robotond/wd_relay3/README.md

# wd_relay3
Highlights:
MCU platform: STM32G070CBT6
On board switching power supply with XL1509-ADJ
RS-485 interface
2 pcs of safety DPDT relays with hardware watchdog timers (SN74AHC123)
1 pc DPDT relay.
MAX 24V DC only
HW: KiCAD project with schematics, PCB, gerbers
SW: STM32CUBEIDE Version: 1.12.1 Build: 16088_20230420_1057 (UTC)
