robotond/wd_relay3/HARDWARE/wd_relay3/wd_relay3.kicad_pcb

## KiCad design HARDWARE/wd_relay3/wd_relay3.kicad_pcb (2023-06-29)

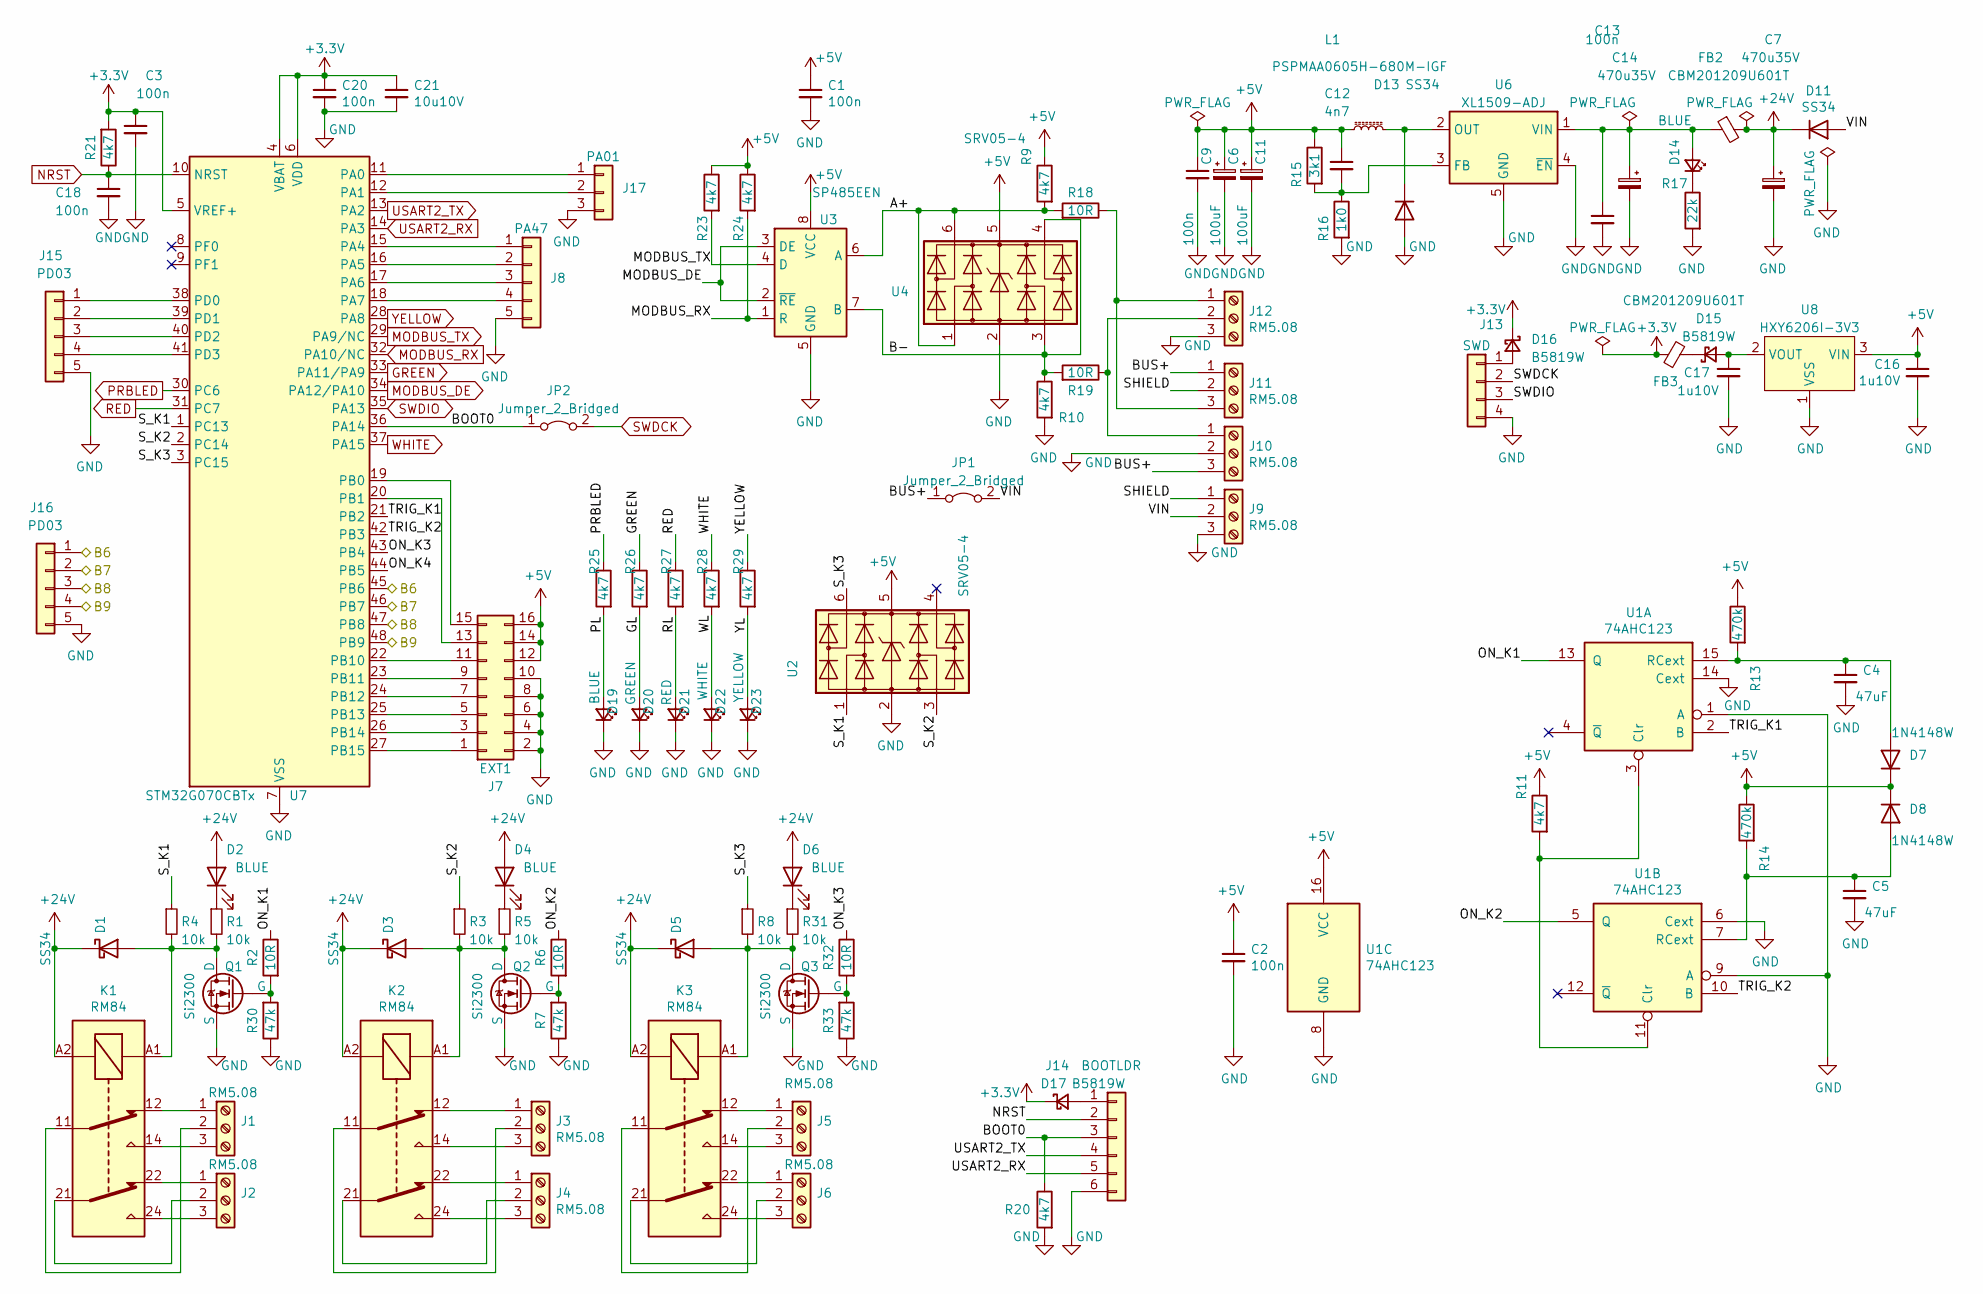
[picture p1: schematic wd_relay3.kicad_sch]

Parts:
C1, C2, C3, C9, C13, C18, C20: 100n; C_0603_1608Metric; LCSC C14663
C4, C5: 47uF; C_0805_2012Metric; LCSC C16780
C6, C11: 100uF; CP_Elec_5x5.4; LCSC C191859
C7, C14: 470u35V; CP_Elec_10x10.5; LCSC C976030
C12: 4n7; C_0603_1608Metric_Pad1.08x0.95mm_HandSolder; LCSC C696859
C16, C17: 1u10V; C_0603_1608Metric_Pad1.08x0.95mm_HandSolder; LCSC C59782
C21: 10u10V; C_0603_1608Metric; LCSC C32635
D1, D3, D5, D11, D13: SS34; D_SMA; LCSC C8678
D2, D4, D6, D14, D19: BLUE; LED_0603_1608Metric_Pad1.05x0.95mm_HandSolder; LCSC C965807
D7, D8: 1N4148W; D_SOD-123; LCSC C81598
D15, D16, D17: B5819W; D_SOD-123; LCSC C2943878
D20: GREEN; LED_0603_1608Metric_Pad1.05x0.95mm_HandSolder; LCSC C965805
D21: RED; LED_0603_1608Metric_Pad1.05x0.95mm_HandSolder; LCSC C965799
D22: WHITE; LED_0603_1608Metric_Pad1.05x0.95mm_HandSolder; LCSC C965808
D23: YELLOW; LED_0603_1608Metric_Pad1.05x0.95mm_HandSolder; LCSC C965802
FB2, FB3: CBM201209U601T; L_0805_2012Metric_Pad1.15x1.40mm_HandSolder; LCSC C139168
J1, J2, J3, J4, J5, J6, J9, J10, J11, J12: RM5.08; TerminalBlock_bornier-3_P5.08mm
J7: EXT1; PinHeader_2x08_P2.54mm_Vertical
J8: PA47; JST_XH_B5B-XH-A_1x05_P2.50mm_Vertical
J13: SWD; JST_XH_B4B-XH-A_1x04_P2.50mm_Vertical
J14: BOOTLDR; JST_XH_B6B-XH-A_1x06_P2.50mm_Vertical
J15, J16: PD03; JST_XH_B5B-XH-A_1x05_P2.50mm_Vertical
J17: PA01; JST_XH_B3B-XH-A_1x03_P2.50mm_Vertical
JP1, JP2: Jumper_2_Bridged; SolderJumper-2_P1.3mm_Bridged2Bar_Pad1.0x1.5mm
K1, K2, K3: RM84; Relay_DPDT_Finder_40.52
L1: PSPMAA0605H-680M-IGF; L_6.6x7.1_H3; LCSC C2983094
Q1, Q2, Q3: Si2300; SOT-23_GSD; LCSC C347480
R1, R3, R4, R5, R8, R31: 10k; R_0603_1608Metric_Pad0.98x0.95mm_HandSolder; LCSC C25804
R2, R6, R18, R19, R32: 10R; R_0603_1608Metric_Pad0.98x0.95mm_HandSolder; LCSC C2906983
R7, R30, R33: 47k; R_0603_1608Metric_Pad0.98x0.95mm_HandSolder; LCSC C25819
R9, R10, R11, R20, R21, R23, R24, R25, R26, R27, R28, R29: 4k7; R_0603_1608Metric_Pad0.98x0.95mm_HandSolder; LCSC C23162
R13, R14: 470k; R_0603_1608Metric_Pad0.98x0.95mm_HandSolder; LCSC C23178
R15: 3k1; R_0603_1608Metric_Pad0.98x0.95mm_HandSolder; LCSC C2924132
R16: 1k0; R_0603_1608Metric_Pad0.98x0.95mm_HandSolder; LCSC C2907113
R17: 22k; R_0603_1608Metric_Pad0.98x0.95mm_HandSolder; LCSC C2907015
U1: 74AHC123; SOIC-16_3.9x9.9mm_P1.27mm; LCSC C554214
U2, U4: SRV05-4; SOT-23-6_Handsoldering; LCSC C2836319
U3: SP485EEN; SOIC-8_3.9x4.9mm_P1.27mm; LCSC C6855
U6: XL1509-ADJ; SOIC-8_3.9x4.9mm_P1.27mm; LCSC C74192
U7: STM32G070CBTx; LQFP-48_7x7mm_P0.5mm; LCSC C529338
U8: HXY6206I-3V3; SOT-23; LCSC C5148688

Connections:
+3.3V: C3.1, C20.1, C21.1, D16.1 (K), D17.1 (K), FB3.1, R21.2, U7.4 (VBAT), U7.5 (VREF+), U7.6 (VDD)
+5V: C1.1, C2.1, C6.1, C9.1, C11.1, C12.1, C16.1, D7.1 (K), D8.1 (K), J7.12, J7.14, J7.16, L1.1, R9.1, R11.1, R13.1, R14.1, R15.1, R23.1, R24.1, U1.16 (VCC), U2.5 (VP), U3.8 (VCC), U4.5 (VP), U8.3 (VIN)
+24V: C7.1, D1.1 (K), D2.2 (A), D3.1 (K), D4.2 (A), D5.1 (K), D6.2 (A), D11.1 (K), FB2.2, K1.A2, K2.A2, K3.A2
/A+: R9.2, R18.2, U3.6 (A), U4.1 (I/O1), U4.6 (I/O4)
/B6: J16.1, U7.45 (PB6)
/B7: J16.2, U7.46 (PB7)
/B8: J16.3, U7.47 (PB8)
/B9: J16.4, U7.48 (PB9)
/B-: R10.1, R19.2, U3.7 (B), U4.3 (I/O3), U4.4 (I/O4)
/BOOT0: J14.3, JP2.1 (A), R20.1, U7.36 (PA14)
/BUS+: J10.3, J11.1, JP1.1 (A)
/GL: D20.2 (A), R26.2
/ON_K1: R2.1, U1.13 (Q)
/ON_K2: R6.1, U1.5 (Q)
/ON_K3: R32.1, U7.43 (PB4)
/ON_K4: U7.44 (PB5)
/PL: D19.2 (A), R25.2
/RL: D21.2 (A), R27.2
/SHIELD: J9.1, J11.2
/S_K1: R4.1, U2.1 (I/O1), U7.1 (PC13)
/S_K2: R3.1, U2.3 (I/O3), U7.2 (PC14)
/S_K3: R8.1, U2.6 (I/O4), U7.3 (PC15)
/TRIG_K1: U1.2 (B), U7.21 (PB2)
/TRIG_K2: U1.10 (B), U7.42 (PB3)
/VIN: D11.2 (A), J9.2, JP1.2 (B)
/WL: D22.2 (A), R28.2
/YL: D23.2 (A), R29.2
GND: C1.2, C2.2, C3.2, C4.2, C5.2, C6.2, C7.2, C9.2, C11.2, C13.2, C14.2, C16.2, C17.2, C18.2, C20.2, C21.2, D13.2 (A), D19.1 (K), D20.1 (K), D21.1 (K), D22.1 (K), D23.1 (K), J7.2, J7.4, J7.6, J7.8, J7.10, J8.5, J9.3, J10.2, J12.3, J13.4, J14.6, J15.5, J16.5, J17.3, Q1.2 (S), Q2.2 (S), Q3.2 (S), R7.1, R10.2, R16.2, R17.2, R20.2, R30.1, R33.1, U1.1 (A), U1.6 (Cext), U1.8 (GND), U1.9 (A), U1.14 (Cext), U2.2 (VN), U3.5 (GND), U4.2 (VN), U6.4 (~EN), U6.5 (GND), U6.6 (GND), U6.7 (GND), U6.8 (GND), U7.7 (VSS), U8.1 (VSS)
GREEN: R26.1, U7.33 (PA11/PA9)
MODBUS_DE: U3.2 (~RE), U3.3 (DE), U7.34 (PA12/PA10)
MODBUS_RX: R24.2, U3.1 (R), U7.32 (PA10/NC)
MODBUS_TX: R23.2, U3.4 (D), U7.29 (PA9/NC)
NRST: C18.1, J14.2, R21.1, U7.10 (NRST)
unnamed: C13.1, C14.1, D14.2 (A), FB2.1, U6.1 (VIN)
unnamed: D1.2 (A), K1.A1, Q1.3 (D), R1.2, R4.2
unnamed: D2.1 (K), R1.1
unnamed: D3.2 (A), K2.A1, Q2.3 (D), R3.2, R5.2
unnamed: D4.1 (K), R5.1
unnamed: D5.2 (A), K3.A1, Q3.3 (D), R8.2, R31.2
unnamed: D6.1 (K), R31.1
unnamed: C4.1, D7.2 (A), R13.2, U1.15 (RCext)
unnamed: C5.1, D8.2 (A), R14.2, U1.7 (RCext)
unnamed: D13.1 (K), L1.2, U6.2 (OUT)
unnamed: D14.1 (K), R17.1
unnamed: C17.1, D15.2 (A), U8.2 (VOUT)
unnamed: D15.1 (K), FB3.2
unnamed: D16.2 (A), J13.1
unnamed: D17.2 (A), J14.1
unnamed: J1.1, K1.12
unnamed: J1.2, K1.11
unnamed: J1.3, K1.14
unnamed: J2.1, K1.22
unnamed: J2.2, K1.21
unnamed: J2.3, K1.24
unnamed: J3.1, K2.12
unnamed: J3.2, K2.11
unnamed: J3.3, K2.14
unnamed: J4.1, K2.22
unnamed: J4.2, K2.21
unnamed: J4.3, K2.24
unnamed: J5.1, K3.12
unnamed: J5.2, K3.11
unnamed: J5.3, K3.14
unnamed: J6.1, K3.22
unnamed: J6.2, K3.21
unnamed: J6.3, K3.24
unnamed: J7.1, U7.27 (PB15)
unnamed: J7.3, U7.26 (PB14)
unnamed: J7.5, U7.25 (PB13)
unnamed: J7.7, U7.24 (PB12)
unnamed: J7.9, U7.23 (PB11)
unnamed: J7.11, U7.22 (PB10)
unnamed: J7.13, U7.20 (PB1)
unnamed: J7.15, U7.19 (PB0)
unnamed: J8.1, U7.15 (PA4)
unnamed: J8.2, U7.16 (PA5)
unnamed: J8.3, U7.17 (PA6)
unnamed: J8.4, U7.18 (PA7)
unnamed: J10.1, J12.2, R19.1
unnamed: J11.3, J12.1, R18.1
unnamed: J15.1, U7.38 (PD0)
unnamed: J15.2, U7.39 (PD1)
unnamed: J15.3, U7.40 (PD2)
unnamed: J15.4, U7.41 (PD3)
unnamed: J17.1, U7.11 (PA0)
unnamed: J17.2, U7.12 (PA1)
unnamed: Q1.1 (G), R2.2, R30.2
unnamed: Q2.1 (G), R6.2, R7.2
unnamed: Q3.1 (G), R32.2, R33.2
unnamed: R11.2, U1.3 (Clr), U1.11 (Clr)
unnamed: C12.2, R15.2, R16.1, U6.3 (FB)
PRBLED: R25.1, U7.30 (PC6)
RED: R27.1, U7.31 (PC7)
SWDCK: J13.2, JP2.2 (B)
SWDIO: J13.3, U7.35 (PA13)
USART2_RX: J14.5, U7.14 (PA3)
USART2_TX: J14.4, U7.13 (PA2)
WHITE: R28.1, U7.37 (PA15)
YELLOW: R29.1, U7.28 (PA8)

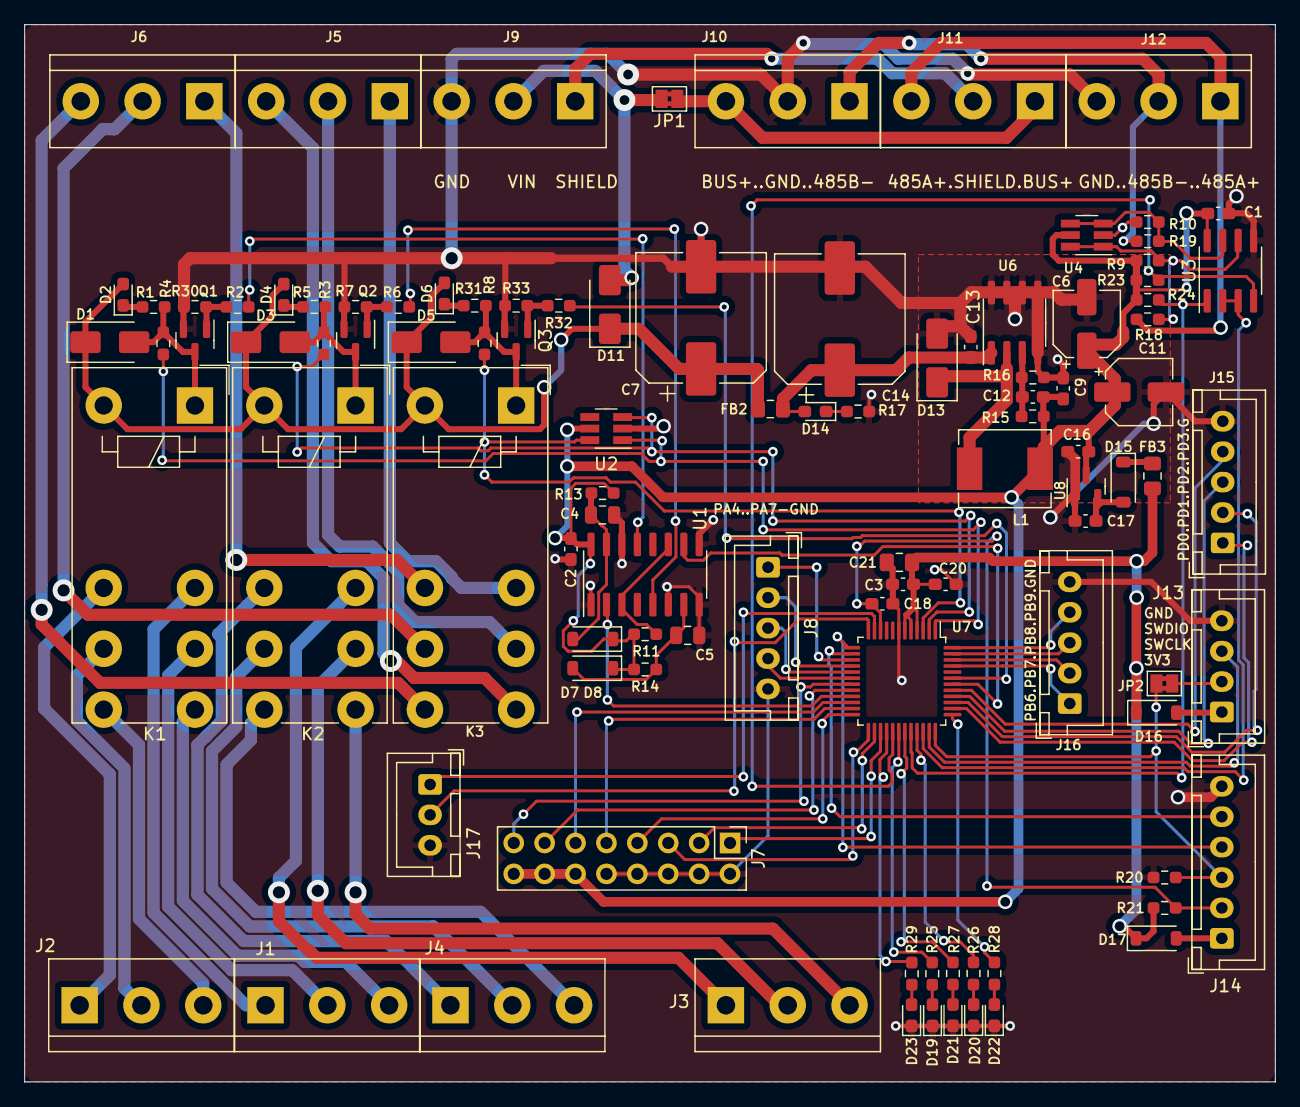
[picture p2: board wd_relay3.kicad_pcb from above]

Board: 2 copper layers, 102.8 x 86.9 mm, 102 parts (0 on the bottom side), 98 nets.
