robotond/wd_relay3/SOFTWARE/wd_relay3/Core/Src/main.c

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
/* Includes ------------------------------------------------------------------*/
#include "main.h"

/* USER CODE BEGIN Includes */
#include "stdio.h"
/* USER CODE END Includes */

UART_HandleTypeDef huart1;
UART_HandleTypeDef huart2;

/* USER CODE BEGIN PV */
int length,pcycles;
char tx_buffer[100];
/* USER CODE END PV */

void SystemClock_Config(void);
static void MX_GPIO_Init(void);
static void MX_USART1_UART_Init(void);
static void MX_USART2_UART_Init(void);
/**
  * @brief  The application entry point.
  * @retval int
  */
int main(void)
{

  /* MCU Configuration--------------------------------------------------------*/

  /* Reset of all peripherals, Initializes the Flash interface and the Systick. */
  HAL_Init();

  /* Configure the system clock */
  SystemClock_Config();

  /* Initialize all configured peripherals */
  MX_GPIO_Init();
  MX_USART1_UART_Init();
  MX_USART2_UART_Init();
  /* Infinite loop */
  /* USER CODE BEGIN WHILE */
  while (1)
  {
	  HAL_GPIO_WritePin(RED_GPIO_Port, RED_Pin, GPIO_PIN_SET);
	  HAL_Delay(500);
	  HAL_GPIO_WritePin(PRBLED_GPIO_Port, PRBLED_Pin, GPIO_PIN_SET);
	  HAL_Delay(500);
	  HAL_GPIO_WritePin(WHITE_GPIO_Port, WHITE_Pin, GPIO_PIN_SET);
	  HAL_Delay(500);
	  HAL_GPIO_WritePin(YELLOW_GPIO_Port, YELLOW_Pin, GPIO_PIN_SET);
	  HAL_Delay(500);
	  HAL_GPIO_WritePin(GREEN_GPIO_Port, GREEN_Pin, GPIO_PIN_SET);
	  HAL_Delay(500);
	  HAL_GPIO_WritePin(TRIG_K1_GPIO_Port, TRIG_K1_Pin, GPIO_PIN_SET);
	  HAL_Delay(500);
	  HAL_GPIO_WritePin(TRIG_K2_GPIO_Port, TRIG_K2_Pin, GPIO_PIN_SET);
	  HAL_Delay(500);
	  HAL_GPIO_WritePin(ON_K3_GPIO_Port, ON_K3_Pin, GPIO_PIN_SET);
	  HAL_Delay(500);
	  HAL_GPIO_WritePin(RED_GPIO_Port, RED_Pin, GPIO_PIN_RESET);
	  HAL_Delay(500);
	  HAL_GPIO_WritePin(PRBLED_GPIO_Port, PRBLED_Pin, GPIO_PIN_RESET);
	  HAL_Delay(500);
	  HAL_GPIO_WritePin(GREEN_GPIO_Port, GREEN_Pin, GPIO_PIN_RESET);
	  HAL_Delay(500);
	  HAL_GPIO_WritePin(WHITE_GPIO_Port, WHITE_Pin, GPIO_PIN_RESET);
	  HAL_Delay(500);
	  HAL_GPIO_WritePin(YELLOW_GPIO_Port, YELLOW_Pin, GPIO_PIN_RESET);
	  HAL_Delay(500);
	  HAL_GPIO_WritePin(TRIG_K1_GPIO_Port, TRIG_K1_Pin, GPIO_PIN_RESET);
	  HAL_Delay(500);
	  HAL_GPIO_WritePin(TRIG_K2_GPIO_Port, TRIG_K2_Pin, GPIO_PIN_RESET);
	  HAL_Delay(500);
	  HAL_GPIO_WritePin(ON_K3_GPIO_Port, ON_K3_Pin, GPIO_PIN_RESET);
	  HAL_Delay(500);
		length=sprintf(tx_buffer,"Motto power cycles since tester power up: %06d \n\r", pcycles++);
		HAL_UART_Transmit(&huart1, (uint8_t*)tx_buffer, length, 20);

	  /* USER CODE END WHILE */

    /* USER CODE BEGIN 3 */
  }
  /* USER CODE END 3 */
}

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
