robotond/wd_relay3/SOFTWARE/wd_relay3/Core/Inc/main.h

#define S_K1_Pin GPIO_PIN_13
#define S_K1_GPIO_Port GPIOC
#define S_K2_Pin GPIO_PIN_14
#define S_K2_GPIO_Port GPIOC
#define S_K3_Pin GPIO_PIN_15
#define S_K3_GPIO_Port GPIOC
#define PA0_Pin GPIO_PIN_0
#define PA0_GPIO_Port GPIOA
#define PA1_Pin GPIO_PIN_1
#define PA1_GPIO_Port GPIOA
#define PA4_Pin GPIO_PIN_4
#define PA4_GPIO_Port GPIOA
#define PA5_Pin GPIO_PIN_5
#define PA5_GPIO_Port GPIOA
#define PA6_Pin GPIO_PIN_6
#define PA6_GPIO_Port GPIOA
#define PA7_Pin GPIO_PIN_7
#define PA7_GPIO_Port GPIOA
#define PB0_Pin GPIO_PIN_0
#define PB0_GPIO_Port GPIOB
#define PB1_Pin GPIO_PIN_1
#define PB1_GPIO_Port GPIOB
#define TRIG_K1_Pin GPIO_PIN_2
#define TRIG_K1_GPIO_Port GPIOB
#define PB10_Pin GPIO_PIN_10
#define PB10_GPIO_Port GPIOB
#define PB11_Pin GPIO_PIN_11
#define PB11_GPIO_Port GPIOB
#define PB12_Pin GPIO_PIN_12
#define PB12_GPIO_Port GPIOB
#define PB13_Pin GPIO_PIN_13
#define PB13_GPIO_Port GPIOB
#define PB14_Pin GPIO_PIN_14
#define PB14_GPIO_Port GPIOB
#define PB15_Pin GPIO_PIN_15
#define PB15_GPIO_Port GPIOB
#define YELLOW_Pin GPIO_PIN_8
#define YELLOW_GPIO_Port GPIOA
#define PRBLED_Pin GPIO_PIN_6
#define PRBLED_GPIO_Port GPIOC
#define RED_Pin GPIO_PIN_7
#define RED_GPIO_Port GPIOC
#define GREEN_Pin GPIO_PIN_11
#define GREEN_GPIO_Port GPIOA
#define WHITE_Pin GPIO_PIN_15
#define WHITE_GPIO_Port GPIOA
#define PD0_Pin GPIO_PIN_0
#define PD0_GPIO_Port GPIOD
#define PD1_Pin GPIO_PIN_1
#define PD1_GPIO_Port GPIOD
#define PD2_Pin GPIO_PIN_2
#define PD2_GPIO_Port GPIOD
#define PD3_Pin GPIO_PIN_3
#define PD3_GPIO_Port GPIOD
#define TRIG_K2_Pin GPIO_PIN_3
#define TRIG_K2_GPIO_Port GPIOB
#define ON_K3_Pin GPIO_PIN_4
#define ON_K3_GPIO_Port GPIOB
#define PB5_Pin GPIO_PIN_5
#define PB5_GPIO_Port GPIOB
#define PB6_Pin GPIO_PIN_6
#define PB6_GPIO_Port GPIOB
#define PB7_Pin GPIO_PIN_7
#define PB7_GPIO_Port GPIOB
#define PB8_Pin GPIO_PIN_8
#define PB8_GPIO_Port GPIOB
#define PB9_Pin GPIO_PIN_9
#define PB9_GPIO_Port GPIOB
