robotond/wd_relay3/(commit log)

2023-06-29 Initial commit, added hardware and software files from local folder
    [bom.csv, designators.csv, positions.csv, wd_relay3.kicad_pcb, wd_relay3.kicad_sch, wd_relay3.sch]
2024-09-04 Relay K3 periodic operation added
    [wd_relay3.kicad_sch]
