robotond/wd_relay3/(notices)

Notices in the files:
SOFTWARE/wd_relay3/Core/Inc/main.h:
Copyright (c) 2023 STMicroelectronics.
All rights reserved.
This software is licensed under terms that can be found in the LICENSE file
